cat40/task-controller/hardware/task-controller/bom.ods

Sheet: Money Budget
PN | JLC PN | Price | Quantity | Total | Extended? | Extended fee | Extended fee per part | Extended fee per unit | Notes
W25Q128JVSIQ | C179173 | 0.81 | 0 | 0 | n | 0 | #DIV/0! | 0 | Flash
RP2040 | C2040 | 1.1055 | 1 | 1.1055 | y | 3 | 0.6 | 0.6 | Microcontroller
ABM8-272-T3 | C20625731 | 0.3645 | 1 | 0.3645 | y | 3 | 0.6 | 0.6 | Crystal
0402CG150J500NT | C1548 | 0.001 | 2 | 0.002 | n | 0 | 0 | 0 | Crystal load caps (math not done)
0603WAF270JT5E | C25190 | 0.0011 | 2 | 0.0022 | preferred | 0 | 0 | 0 | 27R USB termination
W25Q32JVSSIQ | C179173 | 0.375 | 1 | 0.375 | y | 3 | 0.6 | 0.6 | 32Mbit flash
CL05B104KO5NNNC | C1525 | 0.0011 | 11 | 0.0121 | n | 0 | 0 | 0 | 100nF 0402
GT-USB-7010ASV | C2988369 | 0.1086 | 1 | 0.1086 | y | 3 | 0.6 | 0.6 | USB Connector
CL21B105KBFNNNE | C28323 | 0.0089 | 2 | 0.0178 | n | 0 | 0 | 0 | 1uF cap
CL10A106KP8NNNC | C19702 | 0.0056 | 1 | 0.0056 | n | 0 | 0 | 0 | 10uF cap
118EC240 | C5355875 | 0.1805 | 3 | 0.5415 | y | 3 | 0.2 | 0.6 | 100uF cap
0402WGF1002TCE | C25744 | 0.0005 |  | 0 | n | 0 | #DIV/0! | 0 | 10k resistor 0402
0402WGF1001TCE | C11702 | 0.0005 |  | 0 | n | 0 | #DIV/0! | 0 | 1k resistor 0402
0402WGF1003TCE | C25741 | 0.001 |  | 0 | n | 0 | #DIV/0! | 0 | 100k resistor 0402
0402WGF4703TCE | C25790 | 0.0005 |  | 0 | preferred | 0 | #DIV/0! | 0 | 470k resistor 0402
0402WGF5101TCE | C25905 | 0.0005 |  | 0 | n | 0 | #DIV/0! | 0 | 5.1k resistor 0402
0603WAF3300T5E | C23138 | 0.001 |  | 0 | n | 0 | #DIV/0! | 0 | 330R resistor 0603
 |  |  |  | 0 |  | 0 | #DIV/0! | 0
TS-1088-AR02016 | C720477 | 0.0423 |  | 0 | n | 0 | #DIV/0! | 0 | Pushbutton
M24C64-RMN6TP | C79988 | 0.1106 | 1 | 0.1106 | preferred | 0 | 0 | 0 | 64kbit eeprom
PCF8523T/1,118 | C2651516 | 0.474 | 1 | 1.05 | y | 3 | 0.6 | 0.6 | SOP-8 RTC
XDCR-1220-006 | C7498147 | 0.1185 | 1 | 0.1185 | y | 3 | 0.6 | 0.6 | CR1220 holder for RTC backup
PH-3PVertical welding | C146054 | 0.0573 | 3 | 0.1719 | y | 3 | 0.2 | 0.6 | 3 pin JST PH for neopixels
 |  |  |  | 0 |  | 0 | #DIV/0! | 0
KT-0805Y | C2296 | 0.0125 | 1 | 0.0125 | n | 0 | 0 | 0 | Yellow indication LED
XC6206P332MR-G | C5446 | 0.1023 | 1 | 0.1023 | n | 0 | 0 | 0 | 3v3 regulator
SN74HCT125DR | C352957 | 0.2063 | 1 | 0.2063 | y | 3 | 0.6 | 0.6 | Buffer/level shifter
PH-2PVertical welding | C64658 | 0.057 | 49 | 2.793 | y | 3 | 0.0122448979591837 | 0.6 | 2 pin JST PH for buttons
 |  |  |  | 0 |  | 0 | #DIV/0! | 0
DM3AT-SF-PEJM5 | C114218 | 1.29 | 1 | 1.29 | y | 3 | 0.6 | 0.6 | uSD holder
 |  |  |  | 0 |  | 0 | #DIV/0! | 0
 |  |  |  | 0 |  | 0 | #DIV/0! | 0
Total |  |  |  | 8.3899 | Total with extended fee: | 14.9899 |  | 4.8 | Number of extended parts: | 11
Quantity | 5 |  |  | 41.9495 |  | 74.9495 |  |  |  | .
 |  |  |  |  | Total BOM + board cost | 26.9899
Shipping | 25 |  |  |  |  | 134.9495
 |  |  |  |  | Total cost with shipping | 31.9899
board cost |  |  |  |  |  | 159.9495
Engeneering fee | 24
Total fees | 24
Board cost | 7.2
Total per unit | 7.2
total per unit with fees | 12

Sheet: Power Budget
Conversion | Vin (V) | Iin (A) | Vout (V) | Iout (A) | Efficency | Power loss (mW) | Components | Power rail | Current (A) | Power (W)
Battery to 4V | 1.5 | 0.258074781225139 | 4 | 0.0811 | 0.838 | 52.5528 | RGB | 4 | 0.06 | 0.24
4V to 3v3 | 4 | 0.0211 | 3.3 | 0.0211 | 0.825 | 12.18525 |  | 4 |  | 0
 |  |  |  |  |  |  |  | 4 |  | 0
 |  |  |  |  |  |  |  | 4 |  | 0
Battery life |  |  |  |  |  |  |  | 4 |  | 0
Battery Typle | Nominal voltage | Capacity (mAh) | Runtime (h) | Note: handwaving the discharge curve’s impact on boost convert’s efficency |  |  |  | 4 |  | 0
CR2020 | 3 | 100 | 0.387484586929716 | 100 is a bit conservative, quick google suggests 110-125 depending on brand |  |  | 3v3 regulator | 4 | 0.0211 | 0.0844
 |  |  | 0 |  |  |  | Total 4V |  | 0.0811 | 0.3244
 |  |  | #DIV/0!
 |  |  |  |  |  |  | Components | Power rail | Current (A) | Power (W) | Notes
 |  |  |  |  |  |  | RP2040 | 3.3 | 0.011 | 0.0363 | Close to max, average will be much lower due to sleep
 |  |  |  |  |  |  | Eeprom | 3.3 | 0.0001 | 0.00033
 |  |  |  |  |  |  | Flash | 3.3 | 0.01 | 0.033 | Varies significantly between read and standby | https://www.winbond.com/resource-files/w25q32jv%20revg%2003272018%20plus.pdf
 |  |  |  |  |  |  |  | 3.3 |  | 0
 |  |  |  |  |  |  |  | 3.3 |  | 0
 |  |  |  |  |  |  |  | 3.3 |  | 0
 |  |  |  |  |  |  |  | 3.3 | 0 | 0
 |  |  |  |  |  |  | Total 3v3 |  | 0.0211 | 0.06963

Sheet: Money Budget_2
PN | JLC PN | Price | Quantity | Total | Extended? | Extended fee | Extended fee per part | Extended fee per unit | Notes
W25Q128JVSIQ | C179173 | 0.81 | 0 | 0 | n | 0 | #DIV/0! | 0 | Flash
RP2040 | C2040 | 1.1055 | 1 | 1.1055 | y | 3 | 0.6 | 0.6 | Microcontroller
ABM8-272-T3 | C20625731 | 0.3645 | 1 | 0.3645 | y | 3 | 0.6 | 0.6 | Crystal
0402CG150J500NT | C1548 | 0.001 | 2 | 0.002 | n | 0 | 0 | 0 | Crystal load caps (math not done)
0603WAF270JT5E | C25190 | 0.0011 | 2 | 0.0022 | preferred | 0 | 0 | 0 | 27R USB termination
W25Q32JVSSIQ | C179173 | 0.375 | 1 | 0.375 | y | 3 | 0.6 | 0.6 | 32Mbit flash
CL05B104KO5NNNC | C1525 | 0.0011 | 11 | 0.0121 | n | 0 | 0 | 0 | 100nF 0402
GT-USB-7010ASV | C2988369 | 0.1086 | 1 | 0.1086 | y | 3 | 0.6 | 0.6 | USB Connector
CL21B105KBFNNNE | C28323 | 0.0089 | 2 | 0.0178 | n | 0 | 0 | 0 | 1uF cap
CL10A106KP8NNNC | C19702 | 0.0056 | 1 | 0.0056 | n | 0 | 0 | 0 | 10uF cap
118EC240 | C5355875 | 0.1805 | 3 | 0.5415 | y | 3 | 0.2 | 0.6 | 100uF cap
0402WGF1002TCE | C25744 | 0.0005 |  | 0 | n | 0 | #DIV/0! | 0 | 10k resistor 0402
0402WGF1001TCE | C11702 | 0.0005 |  | 0 | n | 0 | #DIV/0! | 0 | 1k resistor 0402
0402WGF1003TCE | C25741 | 0.001 |  | 0 | n | 0 | #DIV/0! | 0 | 100k resistor 0402
0402WGF4703TCE | C25790 | 0.0005 |  | 0 | preferred | 0 | #DIV/0! | 0 | 470k resistor 0402
0402WGF5101TCE | C25905 | 0.0005 |  | 0 | n | 0 | #DIV/0! | 0 | 5.1k resistor 0402
0603WAF3300T5E | C23138 | 0.001 |  | 0 | n | 0 | #DIV/0! | 0 | 330R resistor 0603
 |  |  |  | 0 |  | 0 | #DIV/0! | 0
TS-1088-AR02016 | C720477 | 0.0423 |  | 0 | n | 0 | #DIV/0! | 0 | Pushbutton
M24C64-RMN6TP | C79988 | 0.1106 | 1 | 0.1106 | preferred | 0 | 0 | 0 | 64kbit eeprom
PCF8523T/1,118 | C2651516 | 0.474 | 1 | 1.05 | y | 3 | 0.6 | 0.6 | SOP-8 RTC
XDCR-1220-006 | C7498147 | 0.1185 | 1 | 0.1185 | y | 3 | 0.6 | 0.6 | CR1220 holder for RTC backup
PH-3PVertical welding | C146054 | 0.0573 | 3 | 0.1719 | y | 3 | 0.2 | 0.6 | 3 pin JST PH for neopixels
 |  |  |  | 0 |  | 0 | #DIV/0! | 0
KT-0805Y | C2296 | 0.0125 | 1 | 0.0125 | n | 0 | 0 | 0 | Yellow indication LED
XC6206P332MR-G | C5446 | 0.1023 | 1 | 0.1023 | n | 0 | 0 | 0 | 3v3 regulator
SN74HCT125DR | C352957 | 0.2063 | 1 | 0.2063 | y | 3 | 0.6 | 0.6 | Buffer/level shifter
PH-2PVertical welding | C64658 | 0.057 | 49 | 2.793 | y | 3 | 0.0122448979591837 | 0.6 | 2 pin JST PH for buttons
 |  |  |  | 0 |  | 0 | #DIV/0! | 0
DM3AT-SF-PEJM5 | C114218 | 1.29 | 1 | 1.29 | y | 3 | 0.6 | 0.6 | uSD holder
 |  |  |  | 0 |  | 0 | #DIV/0! | 0
 |  |  |  | 0 |  | 0 | #DIV/0! | 0
Total |  |  |  | 8.3899 | Total with extended fee: | 14.9899 |  | 4.8 | Number of extended parts: | 11
Quantity | 5 |  |  | 41.9495 |  | 74.9495 |  |  |  | .
 |  |  |  |  | Total BOM + board cost | 26.9899
Shipping | 25 |  |  |  |  | 134.9495
 |  |  |  |  | Total cost with shipping | 31.9899
board cost |  |  |  |  |  | 159.9495
Engeneering fee | 24
Total fees | 24
Board cost | 7.2
Total per unit | 7.2
total per unit with fees | 12

Sheet: Power Budget_2
Conversion | Vin (V) | Iin (A) | Vout (V) | Iout (A) | Efficency | Power loss (mW) | Components | Power rail | Current (A) | Power (W)
Battery to 4V | 1.5 | 0.258074781225139 | 4 | 0.0811 | 0.838 | 52.5528 | RGB | 4 | 0.06 | 0.24
4V to 3v3 | 4 | 0.0211 | 3.3 | 0.0211 | 0.825 | 12.18525 |  | 4 |  | 0
 |  |  |  |  |  |  |  | 4 |  | 0
 |  |  |  |  |  |  |  | 4 |  | 0
Battery life |  |  |  |  |  |  |  | 4 |  | 0
Battery Typle | Nominal voltage | Capacity (mAh) | Runtime (h) | Note: handwaving the discharge curve’s impact on boost convert’s efficency |  |  |  | 4 |  | 0
AAA | 1.5 | 1200 | 4.6498150431566 |  |  |  | 3v3 regulator | 4 | 0.0211 | 0.0844
AA | 1.5 | 2500 | 9.68711467324291 |  |  |  | Total 4V |  | 0.0811 | 0.3244
 |  |  | #DIV/0!
 |  |  |  |  |  |  | Components | Power rail | Current (A) | Power (W) | Notes
 |  |  |  |  |  |  | RP2040 | 3.3 | 0.011 | 0.0363 | Close to max, average will be much lower due to sleep
 |  |  |  |  |  |  | Eeprom | 3.3 | 0.0001 | 0.00033
 |  |  |  |  |  |  | Flash | 3.3 | 0.01 | 0.033 | Varies significantly between read and standby | https://www.winbond.com/resource-files/w25q32jv%20revg%2003272018%20plus.pdf
 |  |  |  |  |  |  |  | 3.3 |  | 0
 |  |  |  |  |  |  |  | 3.3 |  | 0
 |  |  |  |  |  |  |  | 3.3 |  | 0
 |  |  |  |  |  |  |  | 3.3 | 0 | 0
 |  |  |  |  |  |  | Total 3v3 |  | 0.0211 | 0.06963
