cat40/task-controller/software/config.h

#ifndef CONFIG_H
#define CONFIG_H

#include "pico/stdlib.h"
#include "hardware/uart.h"

// #include "data_structures.h"

#define STARTUP_WAIT        3000

// defaults
#define GOOD_COLOR                  ((0<<16) | (255<<8) | 0)
#define WARNING_COLOR               ((255<<16) | (255<<8) | 0)
#define OVERDUE_COLOR               ((255<<16) | (0<<8) | 0)
#define OVERDUE_LOW_PRIORITY_COLOR  ((255<<16) | (0<<8) | 255)
#define DEFAULT_NUM_PIXELS          1

#define NUM_CHORES                  48

// eeprom stuff
#define SETTINGS_ADDRESS    0
#define CHORES_ADDRESS      (sizeof(settings_packet_t) + 1)
#define EEPROM_ADDRESS      (0xa0 >> 1)

// rtc stuff
#define I2C i2c0

// pin assignments
#define FUNSIES_LED_PIN 4

#define RGB_1_PIN       5
#define RGB_2_PIN       6
#define RGB_3_PIN       7
#define PIXEL_PARAMETERS    (NEO_GRB + NEO_KHZ800)

// there are 10k pullups on the columns due to likely high wiring capacitence
const static uint MATRIX_ROWS[]    = {8, 9, 10, 11, 12, 13, 14};
const static uint MATRIX_COLUMNS[] = {15, 16, 17, 21, 22, 23, 24};
#define NUM_MATRIX_ROWS     7
#define NUM_MATRIX_COLUMNS  7

#define UART_TX_PIN 0
#define UART_RX_PIN 1
#define UART_ID uart0
#define UART_BAUD_RATE 460800

#define I2C_SDA         2
#define I2C_SCL         3

#define SPI_SCK         18
#define SPI_MOSI        19
#define SPI_MISO        20
#define SD_CS           25

#define PHOTORESISTOR_PIN   26
#define BRIGHTNESS_POT      27
#define RTC_INT             28
#define BUTTON              29

// don't touch these
#define ID_LENGTH   16

#endif
