cat40/task-controller/(commit log)

2025-07-18 user interface
    [Power.kicad_sch, bom.ods, button_matrix.kicad_sch, task-controller.kicad_pcb, task-controller.kicad_sch, untitled.kicad_sch, user_interface.kicad_sch]
2025-07-19 most of rest of schematic
    [bom.ods, button_matrix.kicad_sch, peripherals.kicad_sch, task-controller.kicad_sch, user_interface.kicad_sch]
2025-07-19 started layout
    [bom.ods, task-controller.kicad_pcb, task-controller.kicad_sch, user_interface.kicad_sch]
2025-07-19 mostly done layout
    [peripherals.kicad_sch, task-controller.kicad_pcb, user_interface.kicad_sch]
2025-07-19 started routing
    [task-controller.kicad_pcb]
2025-07-21 changed board size
    [bom.ods, mounting.kicad_sch, peripherals.kicad_sch, task-controller.kicad_pcb, task-controller.kicad_sch, user_interface.kicad_sch]
2025-07-21 routed RGB section
    [task-controller.kicad_pcb]
2025-07-24 electrical design passes DRC
    [task-controller.kicad_pcb, task-controller.kicad_sch]
2025-07-27 added graphics
    [graphics.kicad_sch, task-controller.kicad_sch]
2025-07-28 whatever updates
    [task-controller.kicad_sch]
2025-08-02 config pin assignments
2025-08-04 preparing for production export
    [bom.ods, button_matrix.kicad_sch, graphics.kicad_sch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]
2025-08-16 actual final production version
    [bom.ods, button_matrix.kicad_sch, mounting.kicad_sch, peripherals.kicad_sch, task-controller.kicad_sch, user_interface.kicad_sch]
2025-08-16 added schematic for rev0
